jblang/GameController/GameControl.pdf

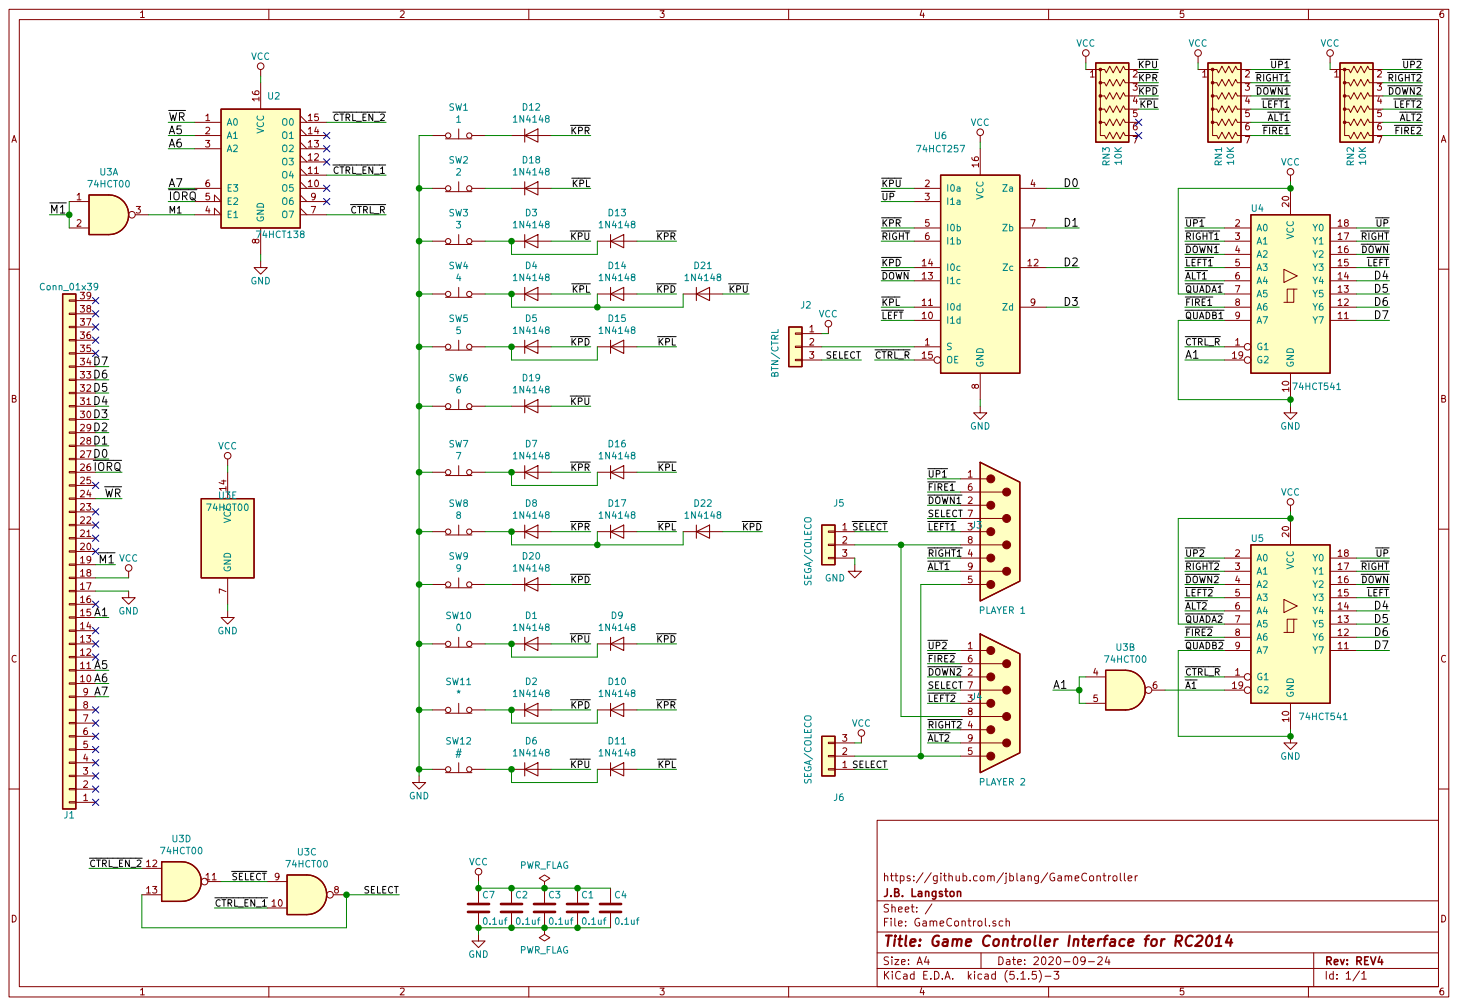
[picture p2: page 1]

https://github.com/jblang/GameController
File: GameControl.sch Sheet: / J.B. Langston

Id: 1/1 Title: Game Controller Interface for RC2014
