jblang/GameController/(commit log)

2018-10-28 Finishing touches
    [ColecoControl.kicad_pcb, ColecoControl.sch]
2018-11-02 Add jumper to support real ColecoVision controllers
    [ColecoControl.kicad_pcb, ColecoControl.sch]
2018-11-11 Updates for REV2
    [ColecoControl.kicad_pcb, ColecoControl.sch]
2018-11-13 Add footprint library for DB-9 connectors
2018-11-14 Update revision number on board
    [ColecoControl.kicad_pcb]
2018-11-25 Rename to GameControl
    [GameControl.kicad_pcb, GameControl.sch]
2019-01-29 Update for multi-assembler compatiblity
2019-01-29 Update title on schematic
    [GameControl.sch]
2020-07-15 Rewire mux to use buttons for both players
    [GameControl.kicad_pcb, GameControl.sch]
2020-09-13 Switch to same capacitor footprint as z80ctrl
    [GameControl.kicad_pcb, GameControl.sch]
2020-09-13 Gerber tweaks
    [GameControl.kicad_pcb]
2020-09-25 REV4 changes
    [GameControl.kicad_pcb, GameControl.sch]
2020-09-26 Fix tactile button footprints
    [GameControl.kicad_pcb, GameControl.sch]
2020-09-27 Final REV4 tweaks
    [GameControl.kicad_pcb]
2020-10-05 Update PDF schematic for REV4
2022-10-22 Upgrade Kicad projects to v6
    [GameControl.kicad_pcb, GameControl.kicad_sch, GameControl.sch]
