jblang/GameController/(notices)

Notices in the files:
ColecoControl.kicad_pcb:
(c) 2018 J.B. Langston
GameControl.kicad_pcb:
(c) 2020 J.B. Langston
